Ghost3379/NX-DBS3/docs/NX-Edge_concept.png

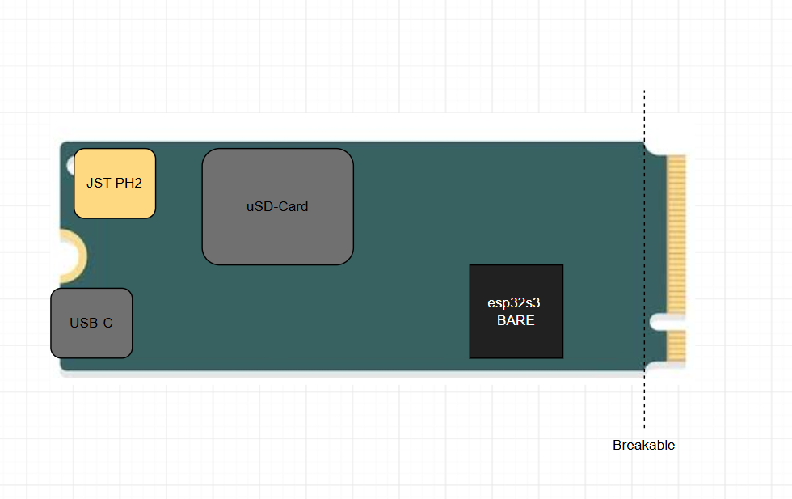
docs/NX-Edge_concept.png
