Ghost3379/NX-DBS3/Edge-PCB/KiCad Library v6 & newer/NX-Edge_3dModels/BGS12WN6E6327XTSA1.stp

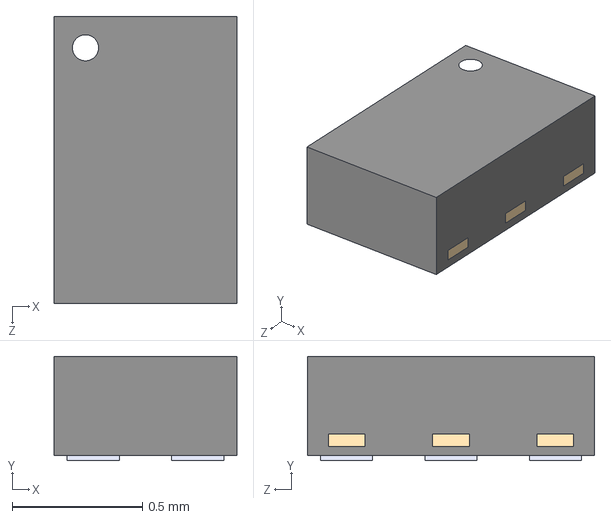
[picture p3: CAD file, 2026-11-11]
Edge-PCB/KiCad Library v6 & newer/NX-Edge_3dModels/BGS12WN6E6327XTSA1.stp
0.7 x 0.4 x 1.10 mm
