Ghost3379/NX-DBS3/Edge-PCB/KiCad Library v6 & newer/NX-Edge_3dModels/ANT_NN02-201_IGN.step

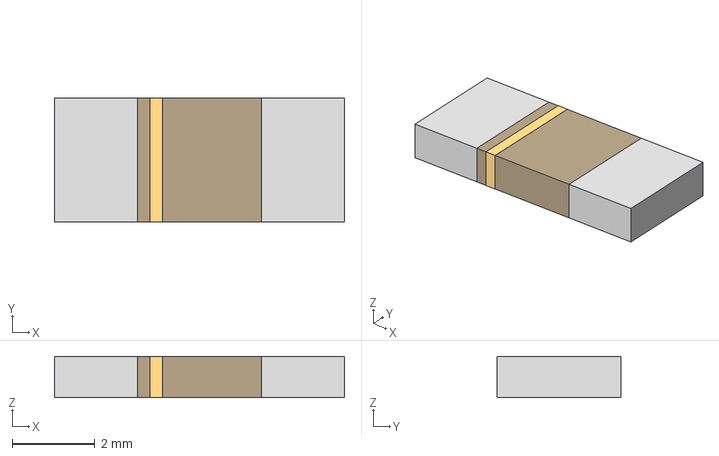
[picture p4: CAD file, 2026-11-11]
Edge-PCB/KiCad Library v6 & newer/NX-Edge_3dModels/ANT_NN02-201_IGN.step
7.01 x 3.00 x 0.996 mm
