Ghost3379/NX-DBS3/Edge-PCB/KiCad Library v6 & newer/NX-Edge_3dModels/U.FL_Hirose_U.FL-R-SMT-1_Vertical.step

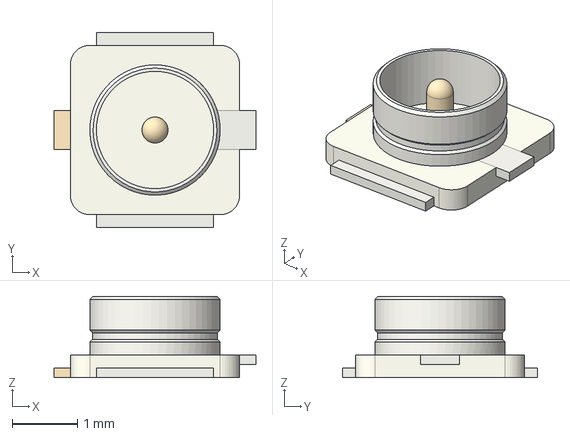
[picture p5: CAD file, 2026-11-11]
Edge-PCB/KiCad Library v6 & newer/NX-Edge_3dModels/U.FL_Hirose_U.FL-R-SMT-1_Vertical.step
3.10 x 3.00 x 1.25 mm
