Ghost3379/NX-DBS3/Edge-PCB/KiCad Library v6 & newer/NX-Edge_3dModels/W25Q128JVPIQ.STEP

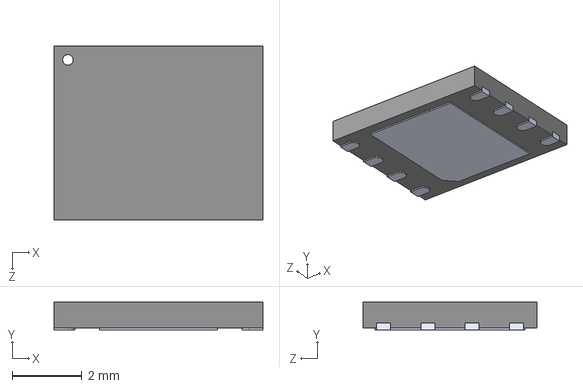
[picture p6: CAD file, 2026-11-09]
Edge-PCB/KiCad Library v6 & newer/NX-Edge_3dModels/W25Q128JVPIQ.STEP
6.00 x 0.8 x 5.00 mm
