Ghost3379/NX-DBS3/Edge-PCB/KiCad Library v6 & newer/NX-Edge_3dModels/ESP32-S3R8.step

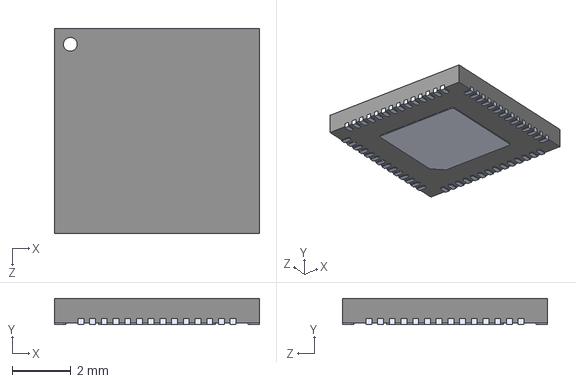
[picture p7: CAD file, 2026-11-06]
Edge-PCB/KiCad Library v6 & newer/NX-Edge_3dModels/ESP32-S3R8.step
7.00 x 0.9 x 7.00 mm
