Ghost3379/NX-DBS3/Edge-PCB/KiCad Library v6 & newer/NX-Edge_3dModels/CPH3225A.step

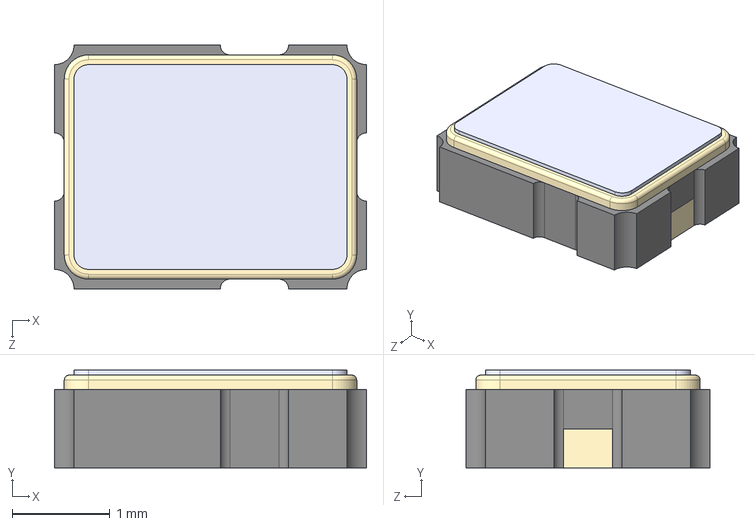
[picture p8: CAD file, 2026-11-06]
Edge-PCB/KiCad Library v6 & newer/NX-Edge_3dModels/CPH3225A.step
3.20 x 1.00 x 2.50 mm
