Ghost3379/NX-DBS3/Edge-PCB/KiCad Library v6 & newer/NX-Edge_3dModels/LGA-8_L8.0-W6.0-P1.27-TL_ZDSD02GLGEAG.step

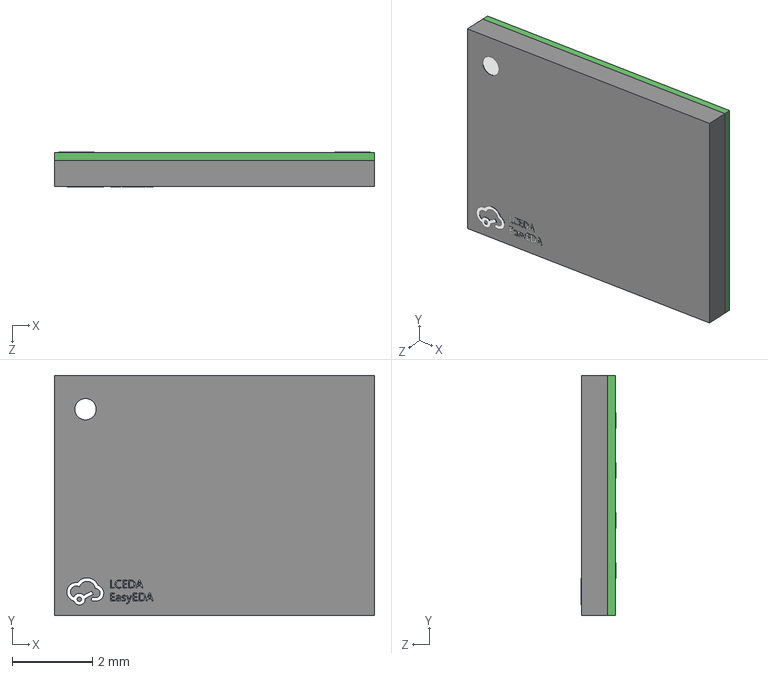
[picture p9: CAD file, 2026-11-06]
Edge-PCB/KiCad Library v6 & newer/NX-Edge_3dModels/LGA-8_L8.0-W6.0-P1.27-TL_ZDSD02GLGEAG.step
8.00 x 6.00 x 0.87 mm
