Ghost3379/NX-DBS3/Edge-PCB/KiCad Library v6 & newer/NX-Edge_3dModels/SOT-23-5_L3.0-W1.7-P0.95-LS2.8-BR.step

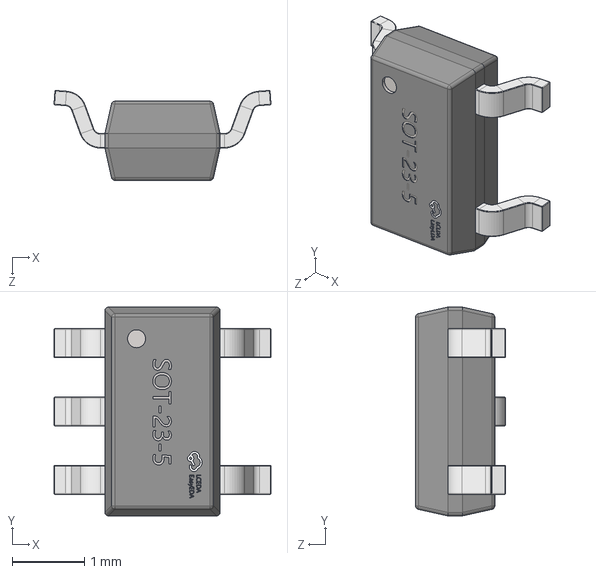
[picture p10: CAD file, 2026-11-06]
Edge-PCB/KiCad Library v6 & newer/NX-Edge_3dModels/SOT-23-5_L3.0-W1.7-P0.95-LS2.8-BR.step
3.01 x 2.90 x 1.25 mm
