Ghost3379/NX-DBS3/Edge-PCB/KiCad Library v6 & newer/NX-Edge_3dModels/LED-SMD_4P-L1.0-W1.0-TL_XL-1010RGBC-WS2812B.step

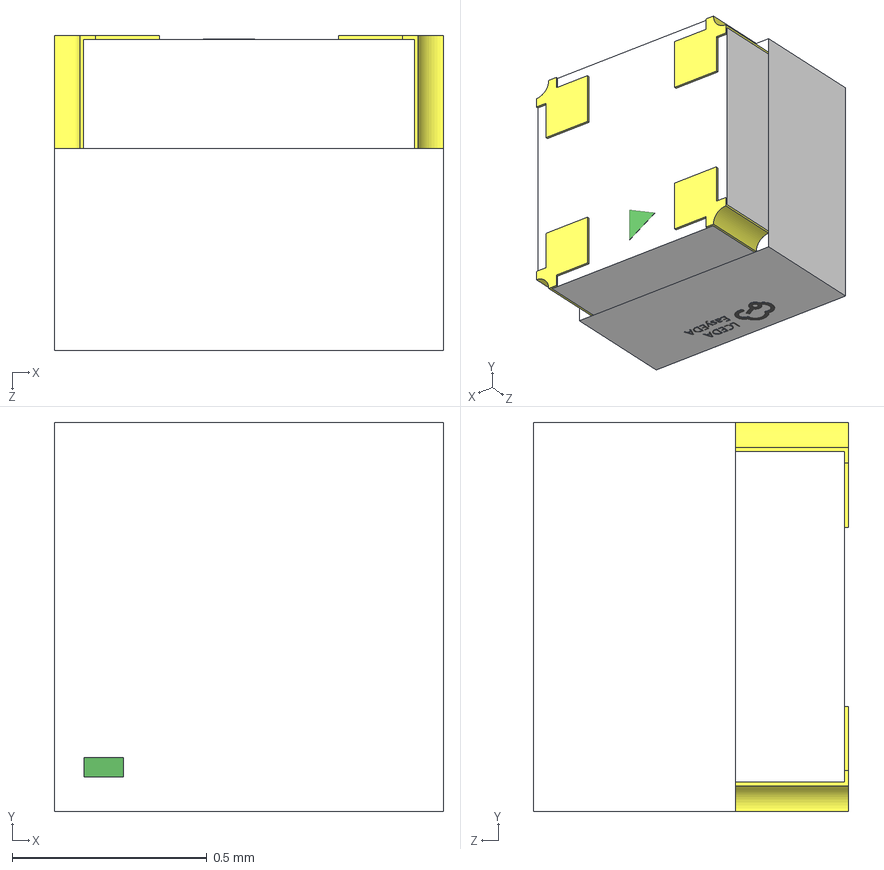
[picture p11: CAD file, 2026-11-06]
Edge-PCB/KiCad Library v6 & newer/NX-Edge_3dModels/LED-SMD_4P-L1.0-W1.0-TL_XL-1010RGBC-WS2812B.step
1.00 x 1.00 x 0.81 mm
