Ghost3379/NX-DBS3/Edge-PCB/KiCad Library v6 & newer/NX-Edge_3dModels/YC248-JR-074K7L.step

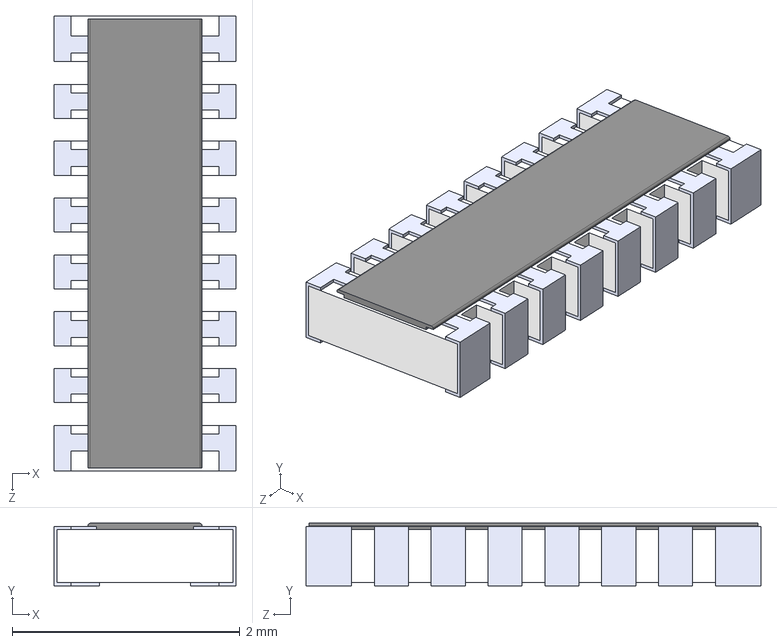
[picture p12: CAD file, 2026-11-06]
Edge-PCB/KiCad Library v6 & newer/NX-Edge_3dModels/YC248-JR-074K7L.step
1.60 x 0.55 x 4.00 mm
