Ghost3379/NX-DBS3/Edge-PCB/KiCad Library v6 & newer/NX-Edge_3dModels/S2B-PH-SM4-TB.step

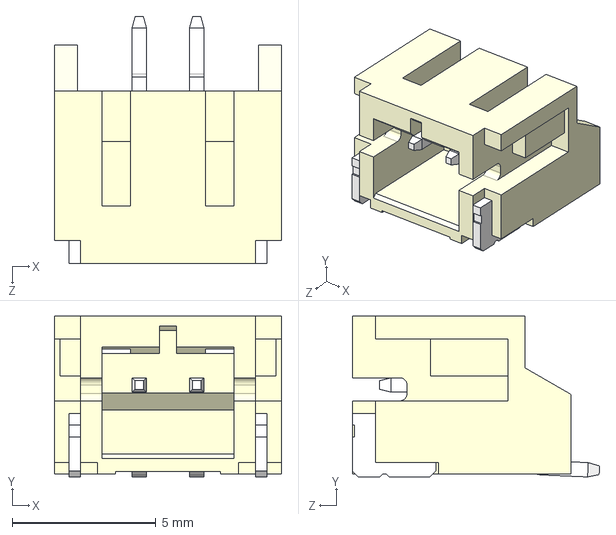
[picture p13: CAD file, 2026-11-06]
Edge-PCB/KiCad Library v6 & newer/NX-Edge_3dModels/S2B-PH-SM4-TB.step
7.90 x 5.60 x 8.60 mm
