Ghost3379/NX-DBS3/Edge-PCB/KiCad Library v6 & newer/NX-Edge_3dModels/UJ20-C-H-G-SMT-1-P16-TR.step

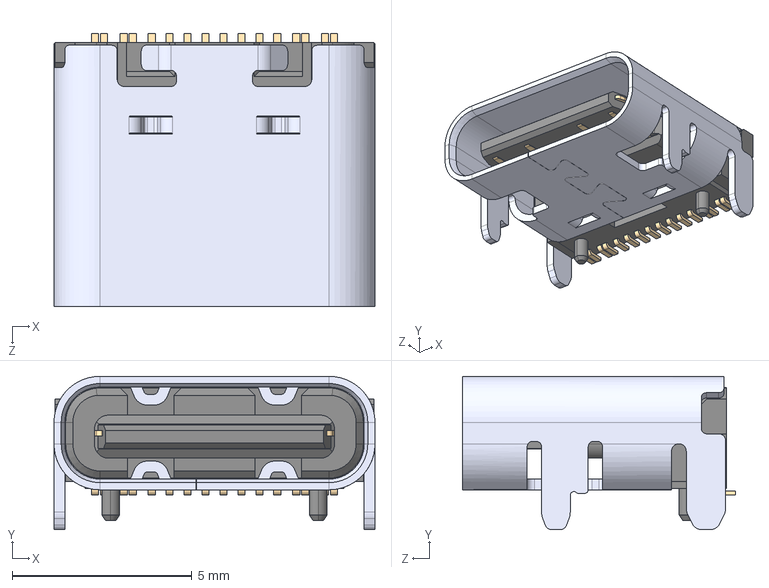
[picture p14: CAD file, 2026-11-06]
Edge-PCB/KiCad Library v6 & newer/NX-Edge_3dModels/UJ20-C-H-G-SMT-1-P16-TR.step
8.94 x 4.27 x 7.60 mm
