Ghost3379/NX-DBS3/Edge-PCB/KiCad Library v6 & newer/NX-Edge_3dModels/RV-3028-C7-32.768KHZ-1PPM-TA-QC.STEP

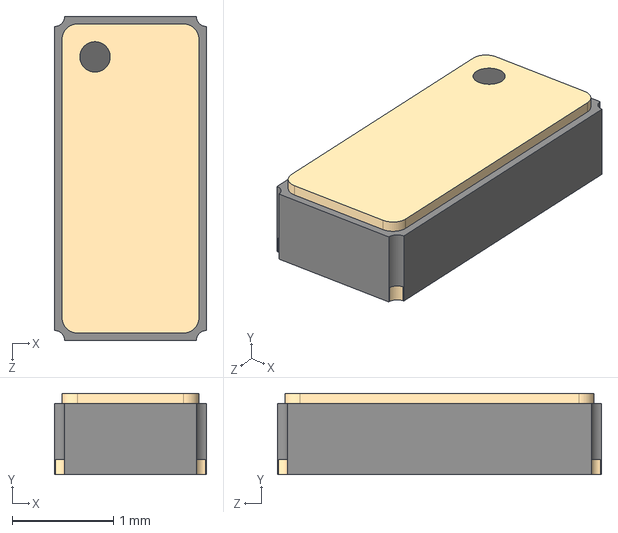
[picture p15: CAD file, 2026-11-06]
Edge-PCB/KiCad Library v6 & newer/NX-Edge_3dModels/RV-3028-C7-32.768KHZ-1PPM-TA-QC.STEP
1.50 x 0.8 x 3.20 mm
