Ghost3379/NX-DBS3/Edge-PCB/KiCad Library v6 & newer/NX-Edge_3dModels/KEY-SMD_TS-1101VS-C-A-A.step

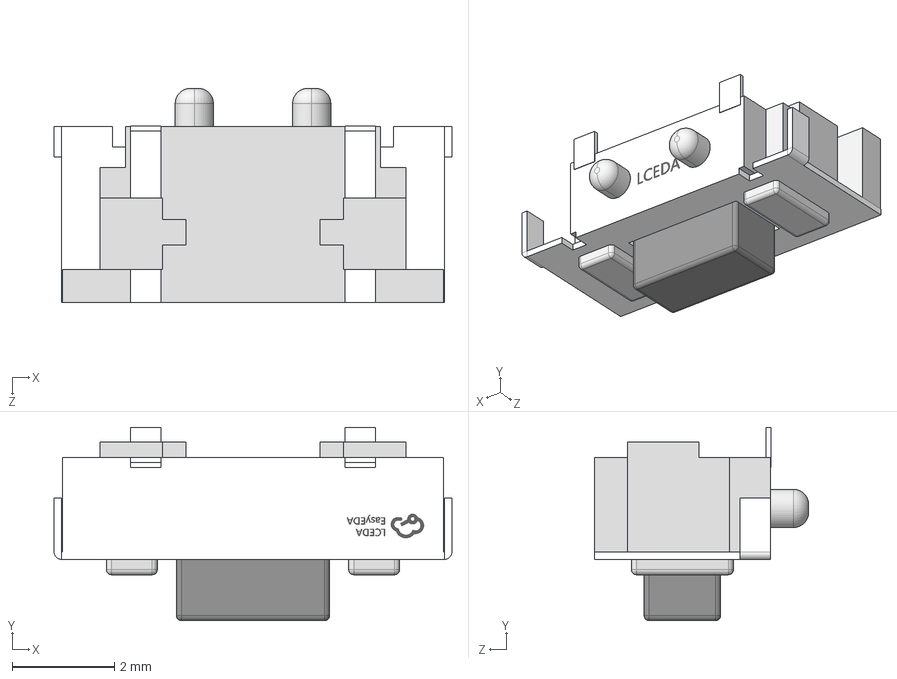
[picture p16: CAD file, 2026-11-06]
Edge-PCB/KiCad Library v6 & newer/NX-Edge_3dModels/KEY-SMD_TS-1101VS-C-A-A.step
7.80 x 3.79 x 4.20 mm
