Ghost3379/NX-DBS3/Edge-PCB/KiCad Library v6 & newer/NX-Edge_3dModels/USBLC6-2P6.step

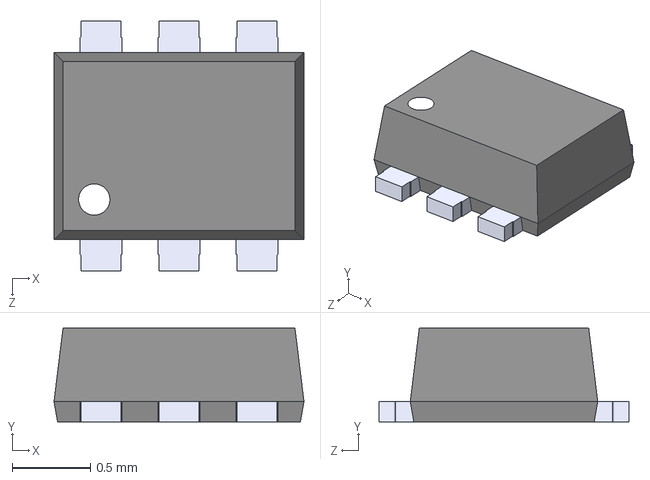
[picture p17: CAD file, 2026-11-06]
Edge-PCB/KiCad Library v6 & newer/NX-Edge_3dModels/USBLC6-2P6.step
1.60 x 0.6 x 1.60 mm
