Ghost3379/NX-DBS3/Edge-PCB/KiCad Library v6 & newer/NX-Edge_3dModels/TS18-5-15-SL-260-SMT-TR.step

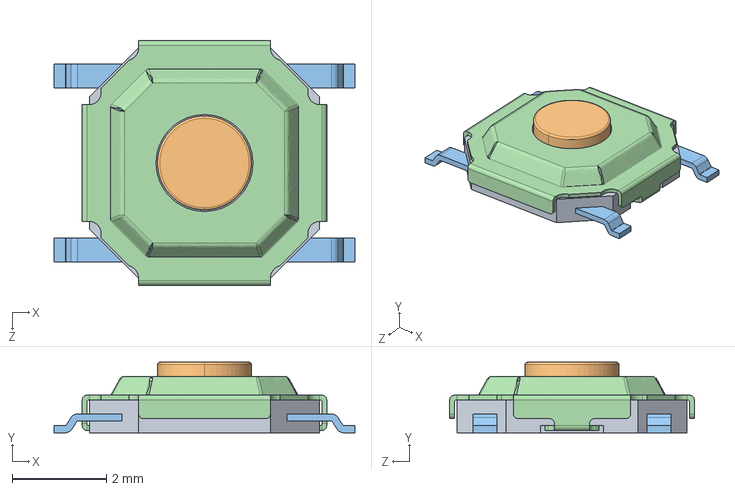
[picture p18: CAD file, 2026-11-06]
Edge-PCB/KiCad Library v6 & newer/NX-Edge_3dModels/TS18-5-15-SL-260-SMT-TR.step
6.40 x 1.50 x 5.20 mm
