Ghost3379/NX-DBS3/Edge-PCB/KiCad Library v6 & newer/NX-Edge_3dModels/1-2328702-0.step

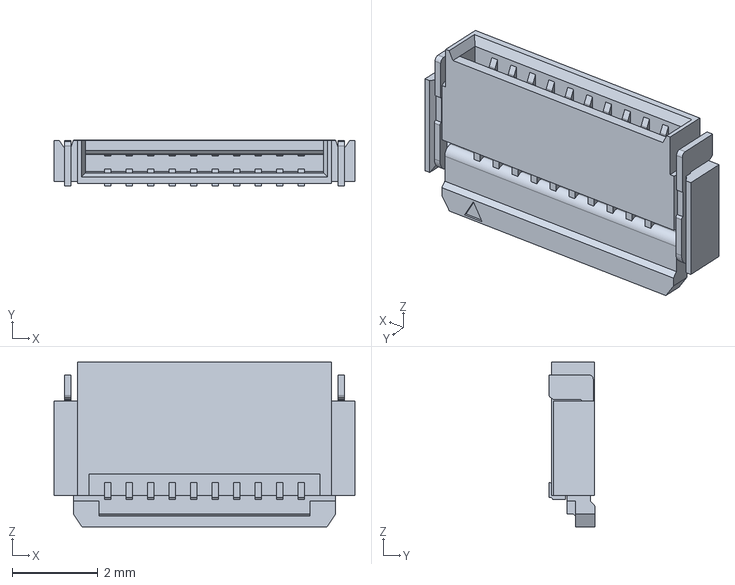
[picture p19: CAD file, 2026-11-06]
Edge-PCB/KiCad Library v6 & newer/NX-Edge_3dModels/1-2328702-0.step
7.00 x 1.06 x 3.83 mm
