Ghost3379/NX-DBS3/(list of files, cad)

Other CAD files:
Edge-PCB/KiCad Library v6 & newer/NX-Edge_3dModels/1051620001.step
Edge-PCB/KiCad Library v6 & newer/NX-Edge_3dModels/BQ25170DSGR.step
Edge-PCB/KiCad Library v6 & newer/NX-Edge_3dModels/MAX17048G_T10.step
