Ghost3379/NX-DBS3/docs/NX-Edge_concept.pdf

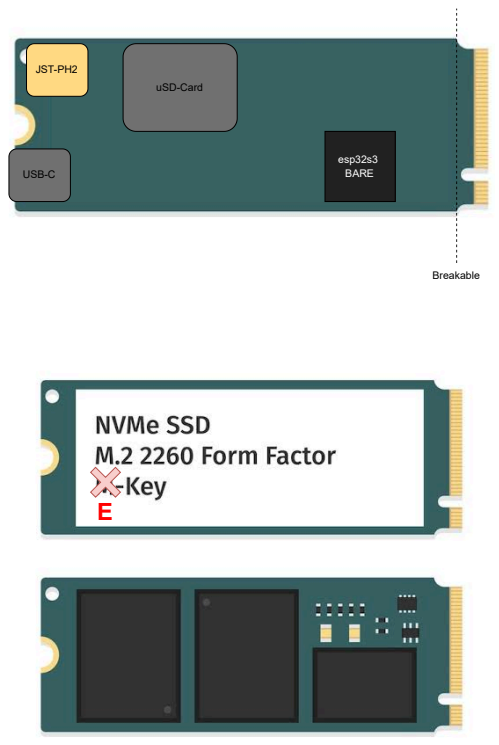
[picture p20: page 1]
USB-C; JST-PH2; uSD-Card; esp32s3 BARE; Breakable
