Ghost3379/NX-DBS3/docs/circuit diagrams/NX-Edge.pdf

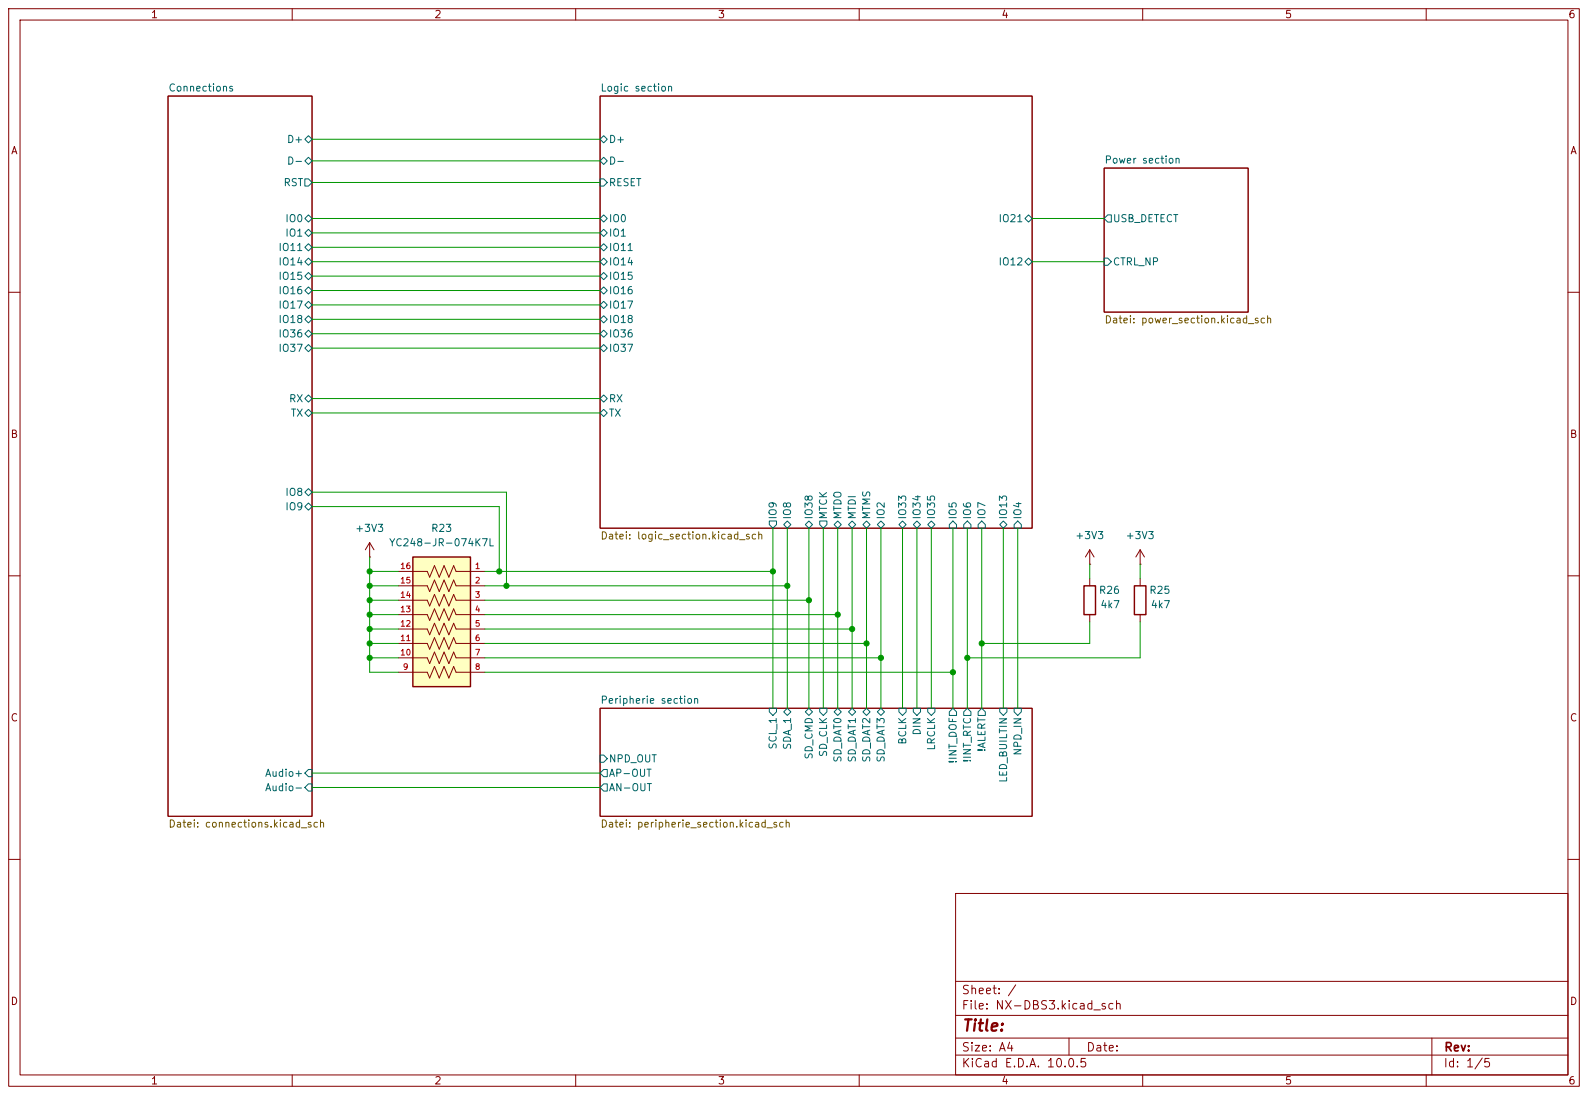
[picture p21: page 1]

IO0 RESET Logic section Datei: logic_section.kicad_sch

Size: A4 | Rev:
KiCad E.D.A. 10.0.5 | Id: 1/5

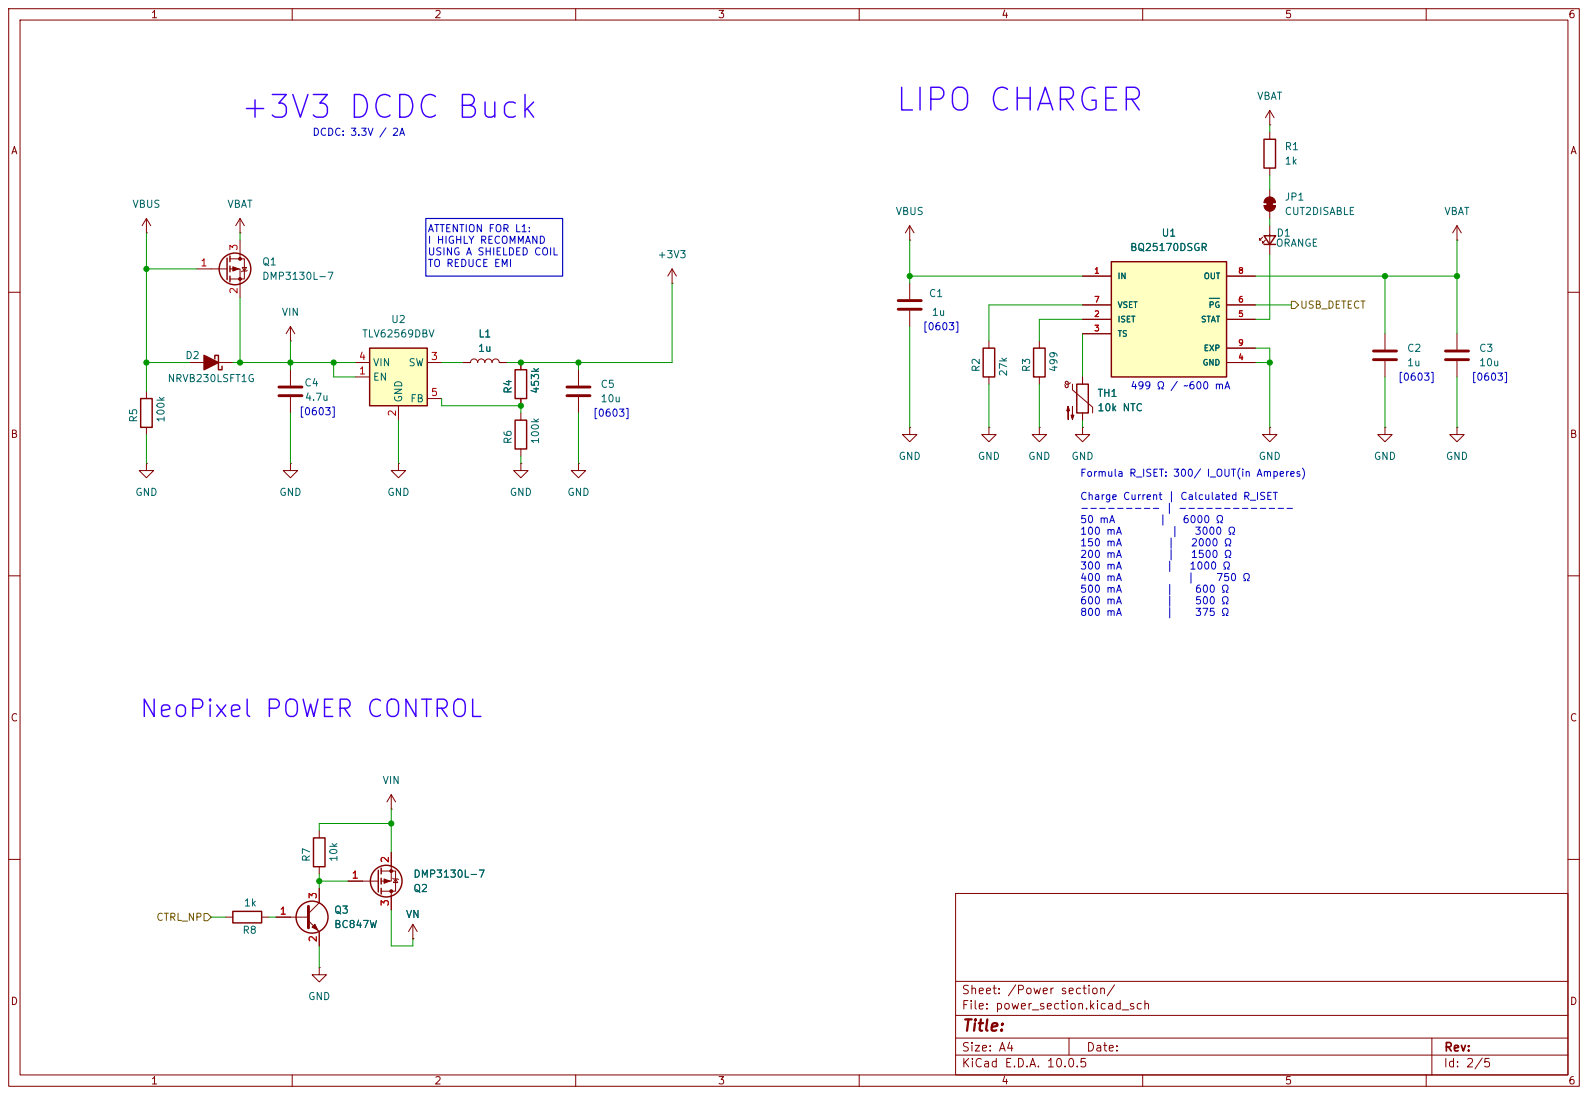
[picture p22: page 2]

[0603] ATTENTION FOR L1:
I HIGHLY RECOMMAND USING A SHIELDED COIL

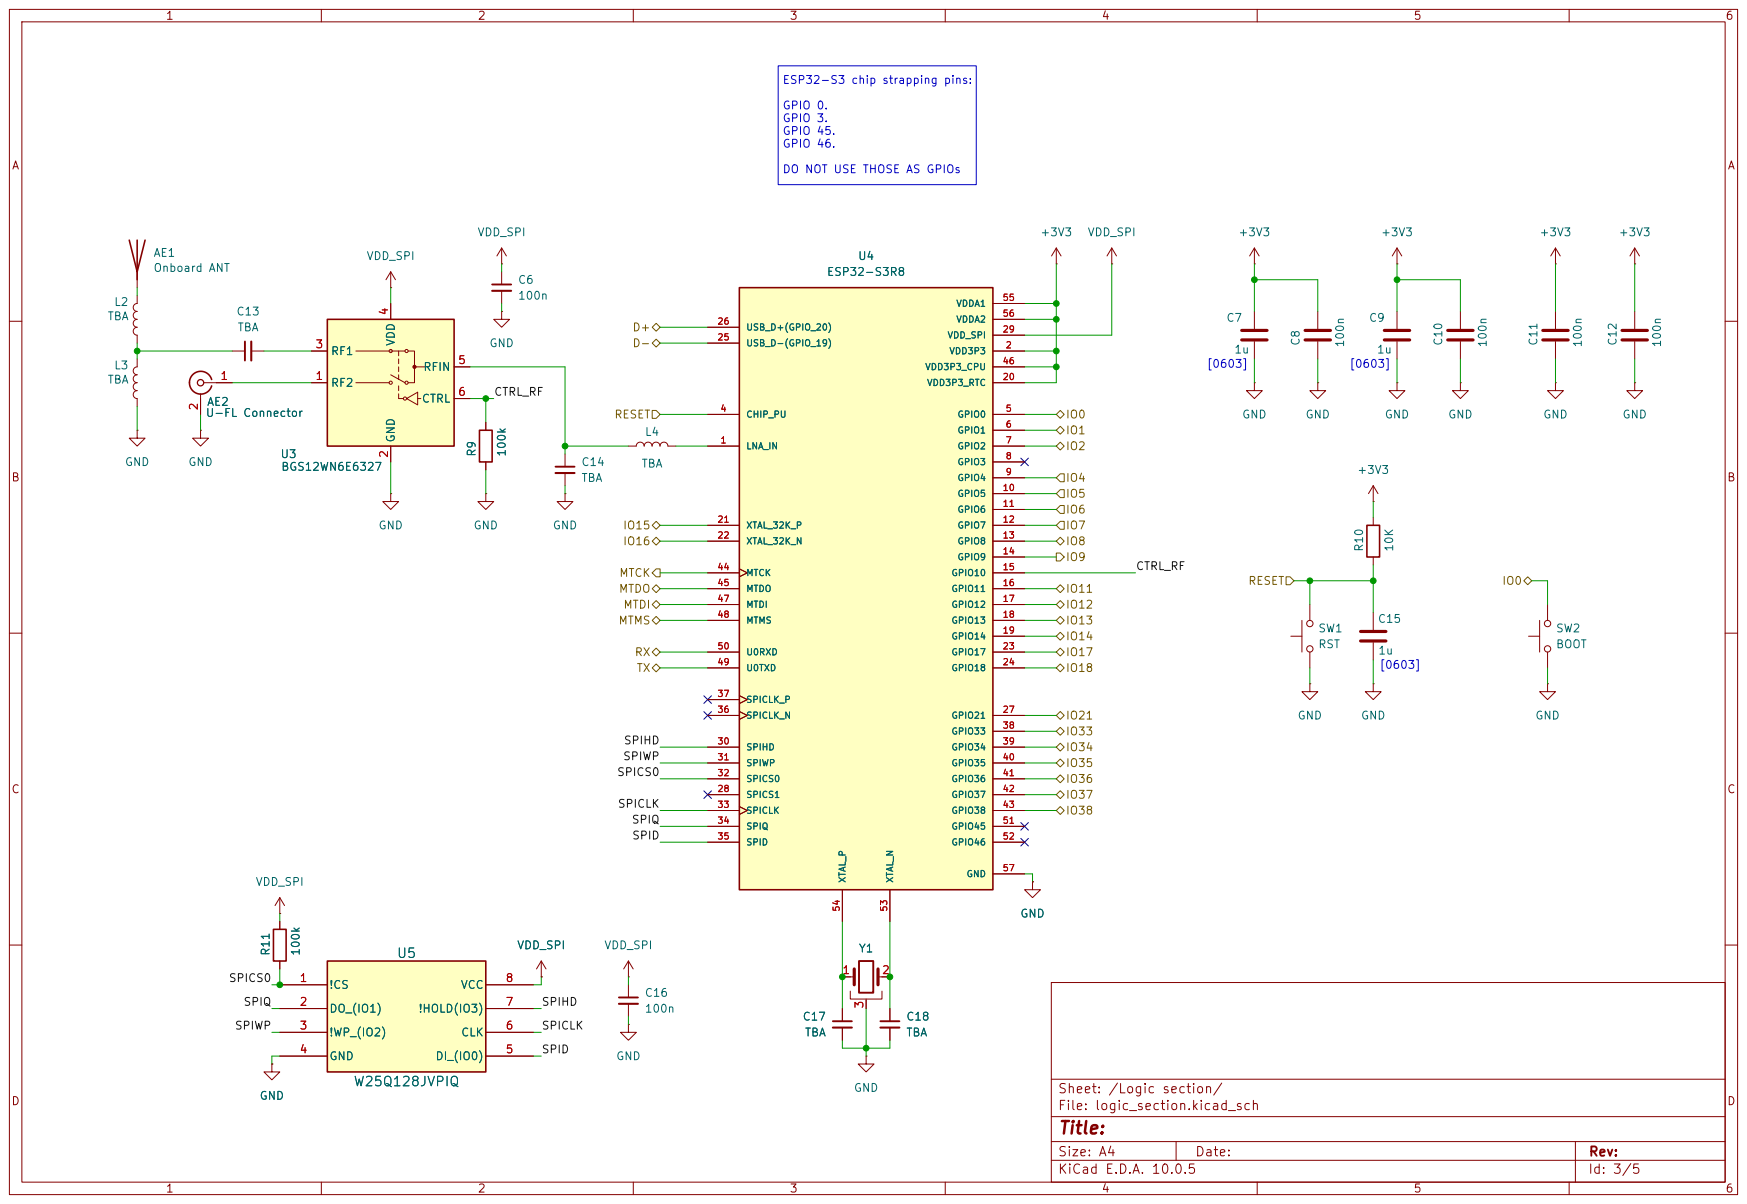
[picture p23: page 3]

ESP32-S3 chip strapping pins: GPIO 0. GPIO 3. GPIO 45. GPIO 46. DO NOT USE THOSE AS GPIOs

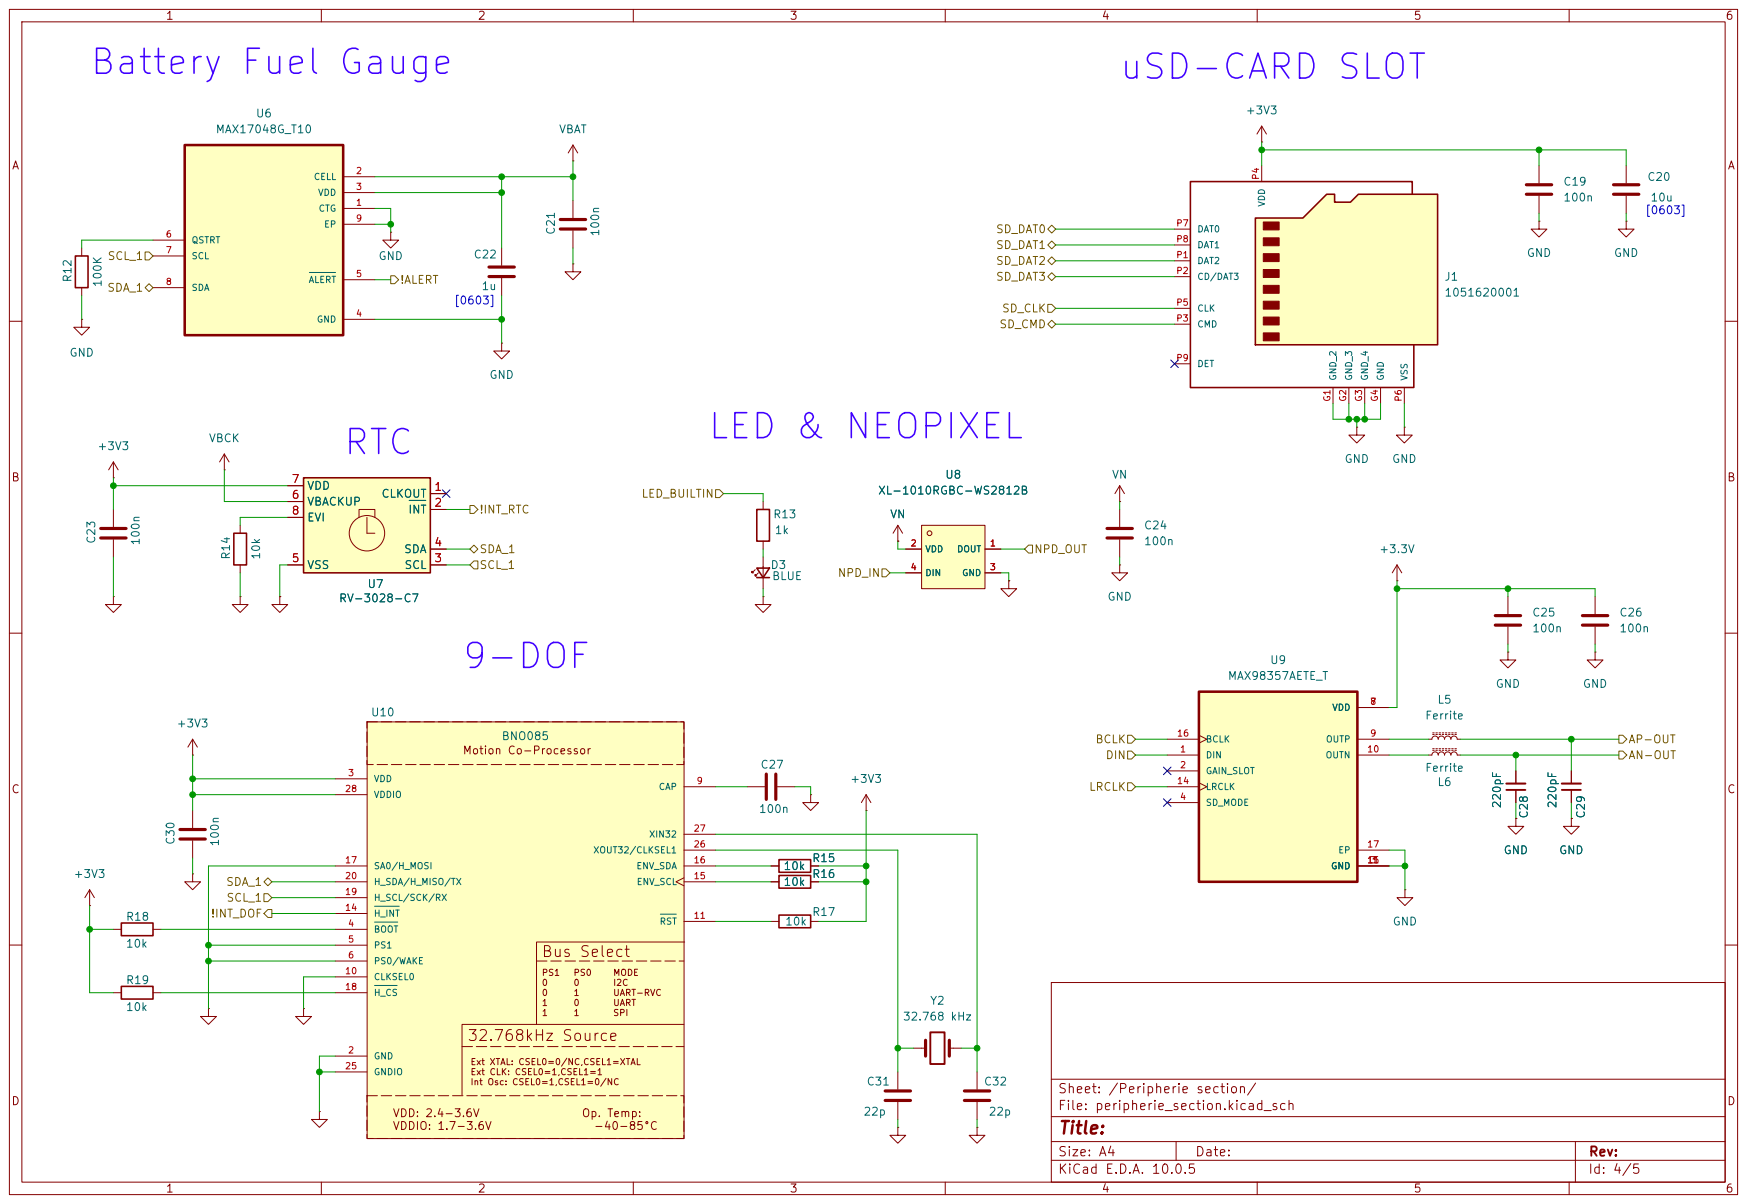
[picture p24: page 4]

XL-1010RGBC-WS2812B
Int Osc: CSEL0=1,CSEL1=0/NC Motion Co-Processor Bus Select PS1

I2C UART-RVC UART SPI GND 2

Ext XTAL: CSEL0=0/NC,CSEL1=XTAL Ext CLK: CSEL0=1,CSEL1=1

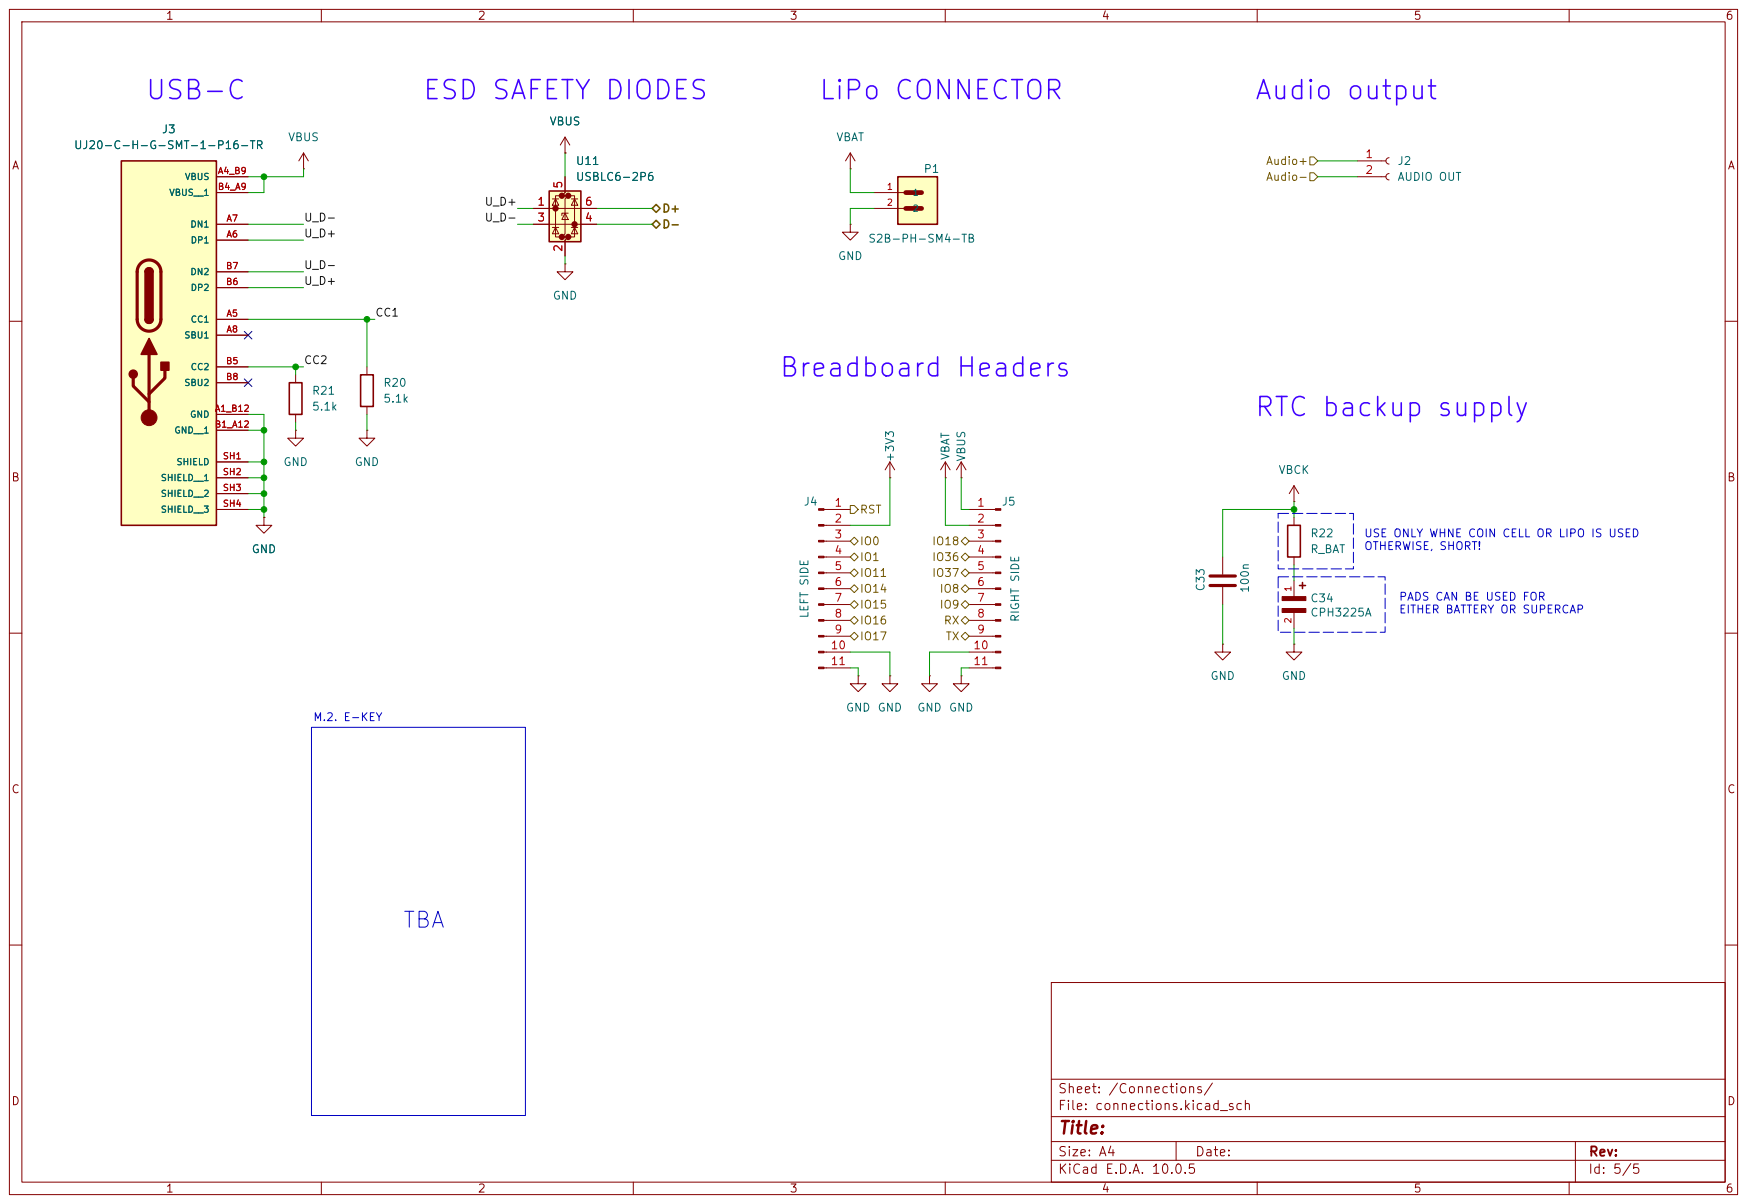
[picture p25: page 5]

EITHER BATTERY OR SUPERCAP USE ONLY WHNE COIN CELL OR LIPO IS USED OTHERWISE, SHORT! M.2. E-KEY

PADS CAN BE USED FOR

GND GND
