Ghost3379/NX-DBS3/Edge-PCB/NX-Edge/NX-Edge.kicad_pcb

## KiCad design Edge-PCB/NX-Edge/NX-Edge.kicad_pcb (2026-11-13)

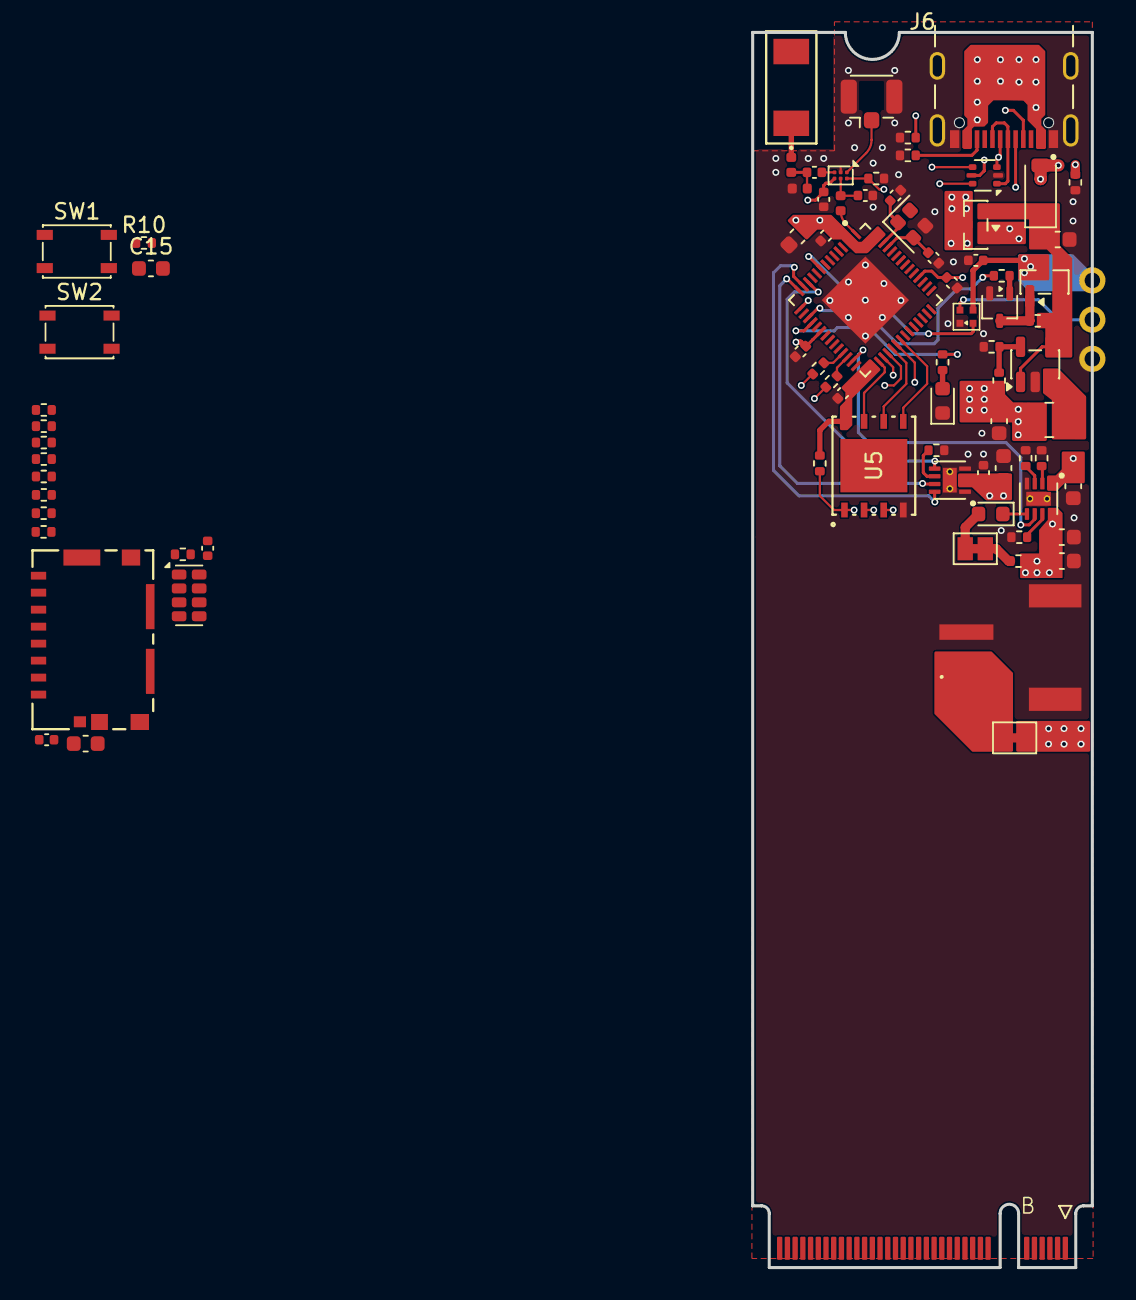
[picture p26: board NX-Edge.kicad_pcb from above]

Board: 6 copper layers, 22.0 x 80.0 mm, 80 parts (0 on the bottom side), 64 nets.

Parts:
AE1: NN02-201; ANT_NN02-201_IGN
AE2: U-FL Connector; U.FL_Hirose_U.FL-R-SMT-1_Vertical
C1, C2, C15, C22: 1u; C_0603_1608Metric
C3, C5, C7, C20: 10u; C_0603_1608Metric
C4: 4.7u; C_0603_1608Metric
C6, C8, C11, C12, C16, C19, C21, C23, C24: 100n; C_0402_1005Metric
C13, C14: TBA; C_0402_1005Metric
C17, C18: 12p; C_0402_1005Metric
D1: ORANGE; LED_0603_1608Metric
D2: NRVB230LSFT1G; D_SOD-123
D3: BLUE; LED_0603_1608Metric
J1: 1051620001; 105162-0001_MOL
J3: UJ20-C-H-G-SMT-1-P16-TR; SAMESKY_UJ20-C-H-G-SMT-1-P16-TR
J6: Bus_M.2_Socket_B; M.2_2280-xx-B
J7: Ext. NeoPixel; PinHeader_1x03_P2.54mm_Vertical
JP1: CUT2DISABLE; SolderJumper-2_P1.3mm_Bridged_Pad1.0x1.5mm
JP2: PLACE4SWITCH; SolderJumper-2_P1.3mm_Bridged_Pad1.0x1.5mm
L1: 1u; L_1008_2520Metric
L2, L3, L4: TBA; L_0402_1005Metric
P1: S2B-PH-SM4-TB; JST_S2B-PH-SM4-TB
Q1, Q2: DMP3130L-7; SOT-23
Q3: BC847W; SOT-323_SC-70
R1, R8, R13: 1k; R_0402_1005Metric
R2: 27k; R_0402_1005Metric
R3: 499; R_0402_1005Metric
R4: 453k; R_0402_1005Metric
R5, R6, R9, R11: 100k; R_0402_1005Metric
R7, R14: 10k; R_0402_1005Metric
R10: 10K; R_0402_1005Metric
R12: 100K; R_0402_1005Metric
R20, R21: 5.1k; R_0402_1005Metric
R23, R28, R29, R30, R31, R32, R33, R34: 4k7; R_0402_1005Metric
R24, R27: 22; R_0402_1005Metric
SW1: RST; SW_SPST_PTS810
SW2: BOOT; SW_SPST_PTS810
TH1: 10k NTC; R_0402_1005Metric
U1: BQ25170DSGR; SON50P200X200X80-9N
U2: TLV62569DBV; SOT-23-5
U3: BGS12WN6E6327; Infineon_PG-TSNP-6-10_0.7x1.1mm_0.7x1.1mm_P0.4mm
U4: ESP32-S3R8; QFN40P700X700X90-57N
U5: W25Q128JVPIQ; WSON_128JVPIQ_WIN
U6: MAX17048G_T10; SON50P200X200X80-9N
U7: RV-3028-C7; MicroCrystal_C7_SON-8_1.5x3.2mm_P0.9mm
U8: XL-1010RGBC-WS2812B; LED-SMD_4P-L1.0-W1.0-TL_XL-1010RGBC-WS2812B
U11: USBLC6-2P6; SOT-666
Y1: 40MHz; Crystal_SMD_2016-4Pin_2.0x1.6mm

Connections:
+3V3: C5.1, C6.1, C7.1, C8.1, C11.1, C12.1, C19.1, C20.1, C23.1, J1.P4 (VDD), L1.2, R4.2, R10.2, R23.1, R28.1, R29.1, R30.1, R31.1, R32.1, R33.1, R34.1, U3.4 (VDD), U4.2 (VDD3P3), U4.3 (VDD3P3), U4.20 (VDD3P3_RTC), U4.46 (VDD3P3_CPU), U4.55 (VDDA1), U4.56 (VDDA2), U7.7 (VDD)
/Connections/CC1: J3.A5 (CC1), R20.1
/Connections/CC2: J3.B5 (CC2), R21.1
/Connections/D+: R24.1, U11.6 (I/O1)
/Connections/D-: R27.1, U11.4 (I/O2)
/Connections/IO0: SW2.2, U4.5 (GPIO0)
/Connections/IO8: R28.2, U4.13 (GPIO8), U6.8 (SDA), U7.4 (SDA)
/Connections/IO9: R23.2, U4.14 (GPIO9), U6.7 (SCL), U7.3 (SCL)
/Connections/NPDE_IN: J7.2, U8.1 (DOUT)
/Connections/RST: C15.1, R10.1, SW1.2, U4.4 (CHIP_PU)
/Connections/U_D+: J3.A6 (DP1), J3.B6 (DP2), U11.1 (I/O1)
/Connections/U_D-: J3.A7 (DN1), J3.B7 (DN2), U11.3 (I/O2)
/Logic section/CTRL_RF: R9.2, U3.6 (CTRL), U4.15 (GPIO10)
/Logic section/IO2: J1.P2 (CD/DAT3), R33.2, U4.7 (GPIO2)
/Logic section/IO4: U4.9 (GPIO4), U8.4 (DIN)
/Logic section/IO5: R34.2, U4.10 (GPIO5)
/Logic section/IO6: U4.11 (GPIO6), U7.2 (~INT)
/Logic section/IO7: U4.12 (GPIO7), U6.5 (~ALERT)
/Logic section/IO12: R8.2, U4.17 (GPIO12)
/Logic section/IO13: R13.1, U4.18 (GPIO13)
/Logic section/IO21: U1.6 (~PG), U4.27 (GPIO21)
/Logic section/IO38: J1.P3 (CMD), R29.2, U4.43 (GPIO38)
/Logic section/MTCK: J1.P5 (CLK), U4.44 (MTCK)
/Logic section/MTDI: J1.P8 (DAT1), R31.2, U4.47 (MTDI)
/Logic section/MTDO: J1.P7 (DAT0), R30.2, U4.45 (MTDO)
/Logic section/MTMS: J1.P1 (DAT2), R32.2, U4.48 (MTMS)
/Logic section/SPICLK: U4.33 (SPICLK), U5.6 (CLK)
/Logic section/SPICS0: R11.1, U4.32 (SPICS0), U5.1 (!CS)
/Logic section/SPID: U4.35 (SPID), U5.5 (DI_(IO0))
/Logic section/SPIHD: U4.30 (SPIHD), U5.7 (!HOLD(IO3))
/Logic section/SPIQ: U4.34 (SPIQ), U5.2 (DO_(IO1))
/Logic section/SPIWP: U4.31 (SPIWP), U5.3 (!WP_(IO2))
GND: AE2.2 (Ext), C1.2, C2.2, C3.2, C4.2, C5.2, C6.2, C7.2, C8.2, C11.2, C12.2, C14.2, C15.2, C16.2, C17.2, C18.2, C19.2, C20.2, C21.2, C22.2, C23.2, C24.2, D3.1 (K), J1.G1 (GND_2), J1.G2 (GND_3), J1.G3 (GND_4), J1.G4 (GND), J1.P6 (VSS), J3.A1_B12 (GND), J3.B1_A12 (GND__1), J3.SH1 (SHIELD), J3.SH2 (SHIELD__1), J3.SH3 (SHIELD__2), J3.SH4 (SHIELD__3), J7.1, L3.1, P1.2, P1.3, P1.4, Q3.2 (E), R2.1, R3.1, R5.1, R6.1, R9.1, R12.1, R14.1, R20.2, R21.2, SW1.1, SW2.1, TH1.2, U1.4 (GND), U1.9 (EXP), U2.2 (GND), U3.2 (GND), U4.57 (GND), U5.4 (GND), U6.1 (CTG), U6.4 (GND), U6.9 (EP), U7.5 (VSS), U8.3 (GND), U11.2 (GND), Y1.3
unnamed: AE1.1 (1_1), L2.2
unnamed: AE2.1 (In), U3.1 (RF2)
unnamed: C13.1, L2.1, L3.2
unnamed: D1.2 (A), JP1.2 (B)
unnamed: D1.1 (K), U1.5 (STAT)
unnamed: D3.2 (A), R13.2
unnamed: J6.2 (3.3V), J6.4 (3.3V), J6.70 (3.3V), J6.72 (3.3V), J6.74 (3.3V)
unnamed: J6.3 (GND), J6.5 (GND), J6.11 (GND), J6.27 (GND), J6.33 (GND), J6.39 (GND), J6.45 (GND), J6.51 (GND), J6.57 (GND), J6.71 (GND), J6.73 (GND)
unnamed: JP1.1 (A), R1.2
unnamed: JP2.2 (B), P1.1
unnamed: Q2.1 (G), Q3.3 (C), R7.1
unnamed: Q3.1 (B), R8.1
unnamed: R3.2, U1.2 (ISET)
unnamed: TH1.1, U1.3 (TS)
unnamed: R2.2, U1.7 (VSET)
unnamed: R4.1, R6.2, U2.5 (FB)
unnamed: L1.1, U2.3 (SW)
unnamed: C13.2, U3.3 (RF1)
unnamed: C14.1, L4.1, U3.5 (RFIN)
unnamed: L4.2, U4.1 (LNA_IN)
unnamed: R24.2, U4.26 (USB_D+(GPIO_20))
unnamed: R27.2, U4.25 (USB_D-(GPIO_19))
unnamed: C18.1, U4.53 (XTAL_N), Y1.2
unnamed: C17.1, U4.54 (XTAL_P), Y1.1
unnamed: R12.2, U6.6 (QSTRT)
unnamed: R14.2, U7.8 (EVI)
VBAT: C2.1, C3.1, C21.1, C22.1, JP2.1 (A), Q1.3 (D), R1.1, U1.8 (OUT), U6.2 (CELL), U6.3 (VDD)
VBUS: C1.1, D2.2 (A), J3.A4_B9 (VBUS), J3.B4_A9 (VBUS__1), Q1.1 (G), R5.2, U1.1 (IN), U11.5 (VBUS)
VDD_SPI: C16.1, R11.2, U4.29 (VDD_SPI), U5.8 (VCC)
VIN: C4.1, D2.1 (K), Q1.2 (S), Q2.2 (S), R7.2, U2.1 (EN), U2.4 (VIN)
VN: C24.1, J7.3, Q2.3 (D), U8.2 (VDD)
