Ghost3379/NX-DBS3/Edge-PCB/M.2.Q+E Key 2260 EXAMPLE/M.2 A+E Key 2260.kicad_pcb

## KiCad design Edge-PCB/M.2.Q+E Key 2260 EXAMPLE/M.2 A+E Key 2260.kicad_pcb (2026-11-10)

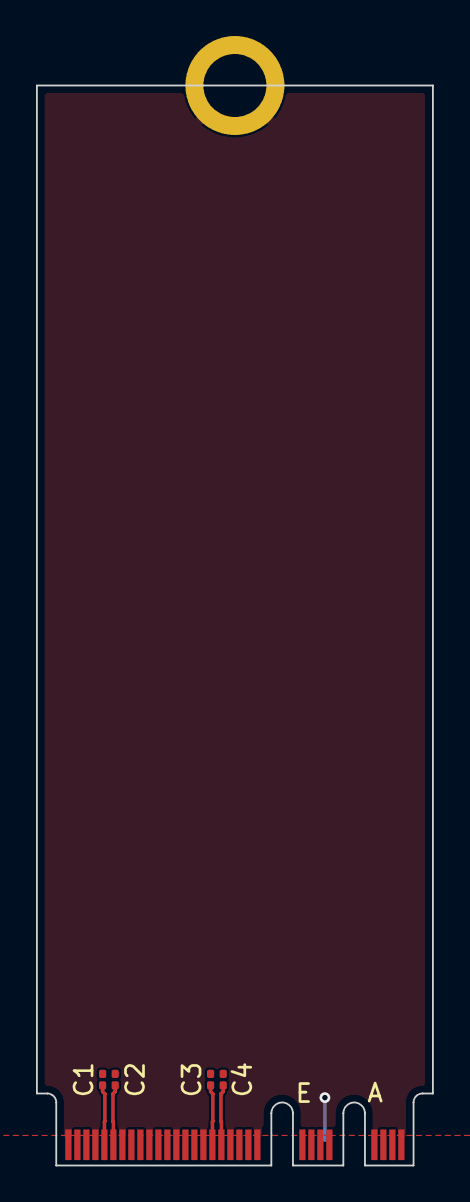
[picture p27: board M.2 A+E Key 2260.kicad_pcb from above]

Board: 2 copper layers, 22.0 x 60.0 mm, 6 parts (0 on the bottom side), 6 nets.

Parts:
C1, C2, C3, C4: 220nF; C_0201_0603Metric
H1: MountingHole_Pad; M.2 Mounting Pad
J1: M.2 A+E Key Connector

Connections:
+3.3V: J1.2 (+3.3V), J1.4 (+3.3V), J1.72 (+3.3V), J1.74 (+3.3V)
/M.2 A+E Key/PET0N: C3.1, J1.43 (PETn0)
/M.2 A+E Key/PET0P: C4.1, J1.41 (PETp0)
/M.2 A+E Key/PET1N: C1.1, J1.67 (RESERVED/PETn1)
/M.2 A+E Key/PET1P: C2.1, J1.65 (RESERVED/PETp1)
GND: H1.1, J1.1 (GND), J1.7 (GND), J1.18 (GND), J1.33 (GND), J1.39 (GND), J1.45 (GND), J1.51 (GND), J1.57 (GND), J1.63 (GND), J1.69 (GND), J1.75 (GND)
