Ghost3379/NX-DBS3/(commit log)

2026-11-06 feat: initial commit for NX-DS3 modular development platform
    [1-2328702-0.step, 1051620001.step, BME280.STEP, BNO085.step, BQ25170DSGR.step, BUZ-SMD_4P-L8.5-W8.5-BR-1.step, CPH3225A.step, KEY-SMD_TS-1101VS-C-A-A.step]
2026-11-06 docs: add concept illustration to README; chore: add ESP32-S3R8 assets and prune unused LDO files
    [ESP32-S3R8.step, NCP167BMX330TBG.step, peripherie_section.kicad_sch]
2026-11-09 chore: rename project, schematics, libraries and docs to NX-DBS3
    [1-2328702-0.step, 1051620001.step, BME280.STEP, BNO085.step, BQ25170DSGR.step, BUZ-SMD_4P-L8.5-W8.5-BR-1.step, CPH3225A.step, ESP32-S3R8.step]
2026-11-09 Update schematic architecture: bus mapping, interrupt lines, and NeoPixel power-path
    [NX-DBS3.kicad_sch, connections.kicad_sch, logic_section.kicad_sch, peripherie_section.kicad_sch, power_section.kicad_sch]
2026-11-10 docs: overhaul hardware architecture, power-path docs, pinout matrix, and credit RomanRom2 M.2 template
    [M.2 A+E Key 2260.kicad_pcb, M.2 A+E Key 2260.kicad_sch, M.2 A+E Key.kicad_sch, NX-DBS3.kicad_sch, PCIe Couple Caps.kicad_sch]
2026-11-10 chore: save work-in-progress schematic updates, footprint repairs, and PCB sync
    [NX-DBS3.kicad_pcb, NX-DBS3.kicad_sch, connections.kicad_sch, logic_section.kicad_sch, peripherie_section.kicad_sch, power_section.kicad_sch]
2026-11-10 refactor: rename project, directories, schematics, and libraries to NX-Edge
    [1-2328702-0.step, 1051620001.step, BNO085.step, BQ25170DSGR.step, CPH3225A.step, ESP32-S3R8.step, KEY-SMD_TS-1101VS-C-A-A.step, LED-SMD_4P-L1.0-W1.0-TL_XL-1010RGBC-WS2812B.step]
2026-11-11 feat(pcb): RF frontend routing, offset screw notch, axial USB-C and initial power layout
    [ANT_NN02-201_IGN.step, BGS12WN6E6327XTSA1.stp, NX-Edge.kicad_pcb, NX-Edge.kicad_sch, U.FL_Hirose_U.FL-R-SMT-1_Vertical.step, connections.kicad_sch, logic_section.kicad_sch, peripherie_section.kicad_sch]
2026-11-11 feat(pcb): route USB data lines with ESD protection, add 22-ohm series resistors, and update 3V3 power stage
    [NX-Edge.kicad_pcb, logic_section.kicad_sch, power_section.kicad_sch]
2026-11-12 chore: save user morning placement adjustments
    [NX-Edge.kicad_pcb, connections.kicad_sch, power_section.kicad_sch]
2026-11-12 feat(pcb): route complete 3V3 buck power stage, LiPo charger, dual JST/solder battery pads, and layer 3 power planes
    [NX-Edge.kicad_pcb]
2026-11-12 feat(pcb): refine Layer 3 power plane mosaic and zone boundaries
    [NX-Edge.kicad_pcb]
2026-11-12 feat(pcb): route 40MHz crystal, CC pulldown resistors, and USB D+/D- lines
    [NX-Edge.kicad_pcb, connections.kicad_sch, logic_section.kicad_sch, peripherie_section.kicad_sch]
2026-11-12 feat(pcb): place and route complete ESP32-S3 decoupling capacitor network
    [NX-Edge.kicad_pcb, logic_section.kicad_sch]
2026-11-12 feat(pcb): route NeoPixel PMOS power switch and 3 castellated edge pads with B.Cu underpass
    [NX-Edge.kicad_pcb, NX-Edge.kicad_sch, connections.kicad_sch, peripherie_section.kicad_sch, power_section.kicad_sch]
2026-11-12 feat(pcb): place and route MAX17048 fuel gauge and battery sense network
    [NX-Edge.kicad_pcb, connections.kicad_sch, peripherie_section.kicad_sch]
2026-11-12 feat(pcb): optimize VDD_SPI flash decoupling path and USB diff pair routing
    [NX-Edge.kicad_pcb]
2026-11-13 feat(pcb): upgrade to 6-layer stackup, optimize via size to 0.45mm, route onboard RGB/LED and fuel gauge signals
    [NX-Edge.kicad_pcb, NX-Edge.kicad_sch, peripherie_section.kicad_sch]
2026-11-13 feat(pcb): added sd card - not routed yet
    [NX-Edge.kicad_pcb, connections.kicad_sch, peripherie_section.kicad_sch]
2026-11-13 docs(readme): update specifications for 6-layer M.2 2280 Key B architecture, embed latest 3D render
    [NX-Edge.kicad_pcb]
